DevanshB99/Turntable_ROS2_Driver/turntable_description/meshes/collision/turntable_disc.stl

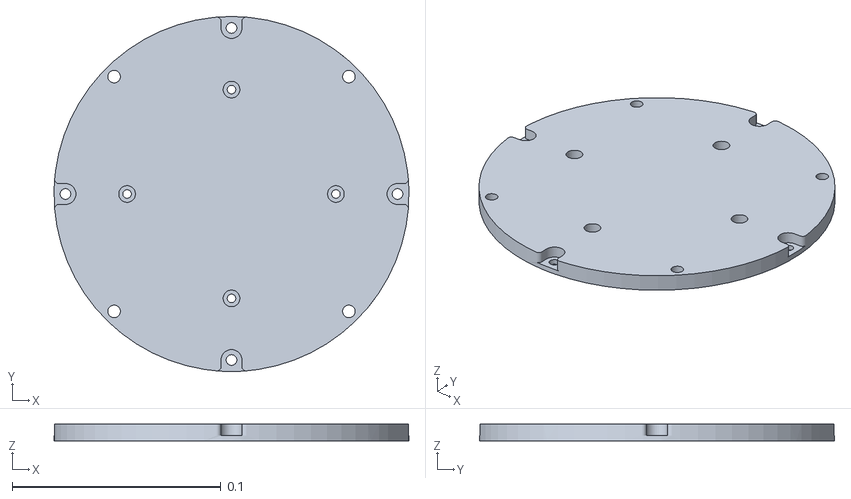
[picture p6: CAD file, 2025-06-07]
turntable_description/meshes/collision/turntable_disc.stl
0.17 x 0.17 x 0.008
