DevanshB99/Turntable_ROS2_Driver/(commit log)

2025-06-07 Complete turntable robot ROS2 integration with hardware interface. Comprehensive ROS2 Humble support for single-DOF turntable robot with full hardware-software integration and motion planning capabil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
    Packages Added:
    turntable_description: Complete URDF/XACRO robot description with ros2_control integration
    turntable_hardware_interface: Custom hardware interface for physical turntable communication
    turntable_moveit_config: MoveIt motion planning configuration generated via setup assistant
    Hardware Interface Details:
    Custom SystemInterface implementation for turntable communication
    Automatic hardware connection detection and status monitoring
    Configurable topic names and publishing optio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
    [joint_limits.yaml, ros2_controllers.yaml, turntable.ros2_control.xacro, turntable.urdf, turntable.urdf.xacro, turntable_common.xacro, turntable_controllers.yaml, turntable_disc.stl]
2025-06-11 Editing the 'turntable_macro.xacro' to additionally have an option to be compliant with other co-ordinate transformation/ frames/ orientations, other than REP-103 standard.
    [turntable_macro.xacro]
2025-07-01 Changed the UDRF and the Kinematic chain for the turntable - added the object_frame. WIP - Trying to add the forward_position_controller now.
    [ros2_controllers.yaml, turntable.urdf, turntable_macro.xacro]
2025-07-02 Made changes to accomodate for 'turntable_forward_position_controller'. Removed 'turntable_controllers.yaml' and added 'ros2_controllers.yaml' instead, standardizing the nomenclature.
    [ros2_controllers.yaml, turntable.ros2_control.xacro, turntable.urdf.xacro, turntable_common.xacro, turntable_controllers.yaml, turntable_macro.xacro]
2025-07-03 Updated the sensors_3d.yaml file
2025-08-20 WIP - Added u-ros for ESP32. Original working Package - turntable_hardware_interface_n : works with Raspberry Pi 4b.
    [turntable_hardware_params.yaml]
2025-08-22 u-ros working on ESP32 over WiFi
    [turntable_hardware_params.yaml]
2025-08-22 Turntable Package - ROS2 Humble/ Micro-ROS Communicates with ESP32 over WiFi
    [turntable_hardware_params.yaml]
2025-08-26 changed initial positions keys
    [turntable.ros2_control.xacro, turntable.urdf.xacro]
2025-09-13 Added a Readme for ESP32 branch.
2025-09-13 Added a README for ESP32 branch
2026-06-02 updated joint limits
    [joint_limits.yaml]
